arnaudcazale/XpertRide_Shield_PCB/3D/connecteur_male.pdf

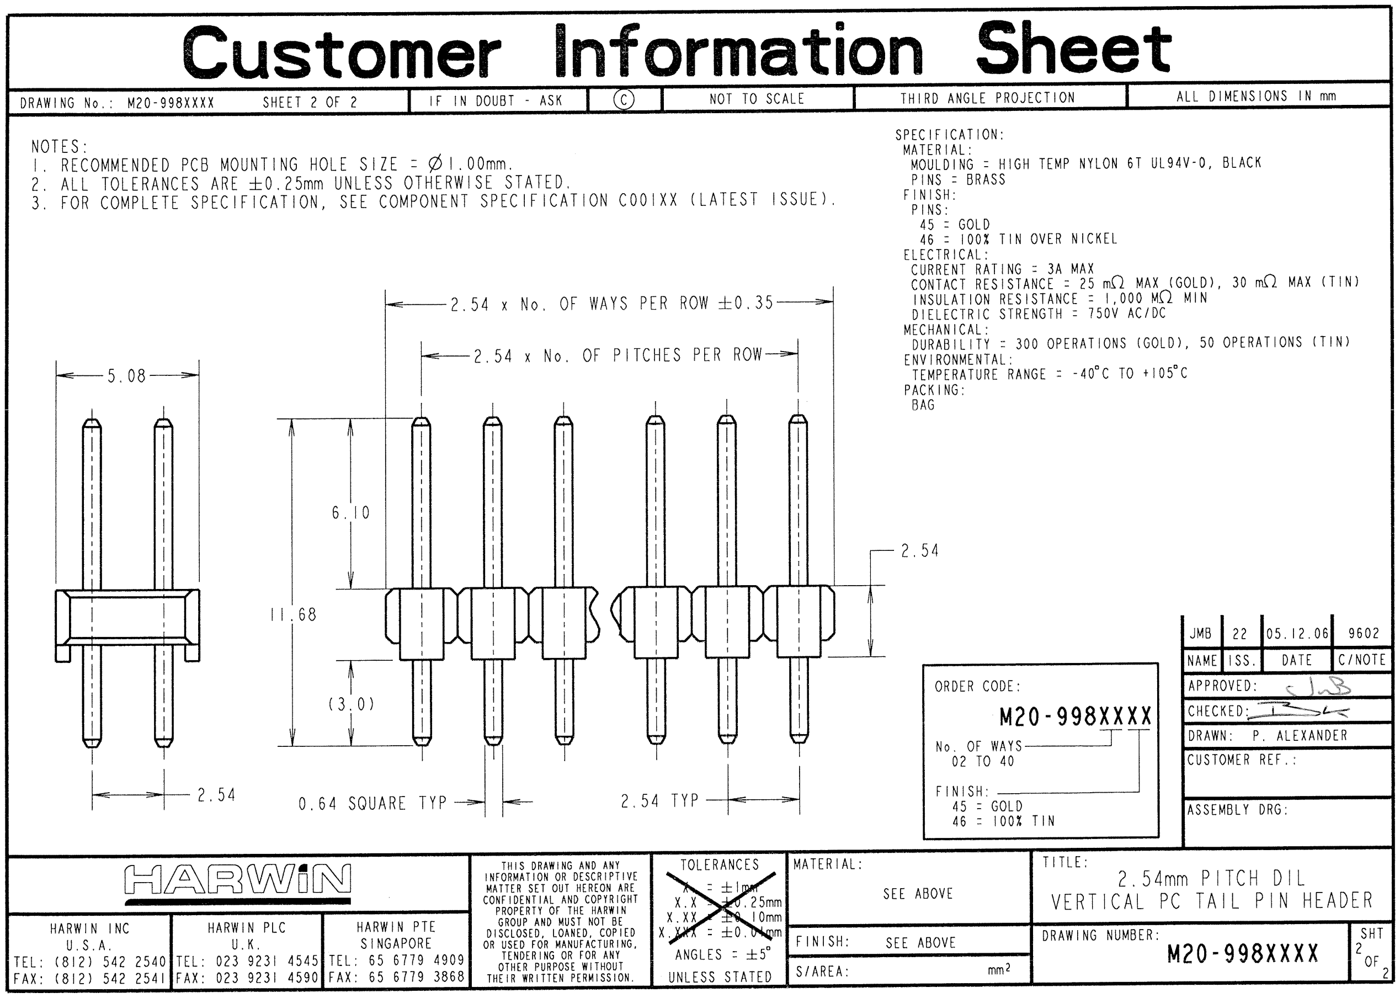
[picture p1: page 1]
