arnaudcazale/XpertRide_Shield_PCB/3D/connecteur_femelle.stp

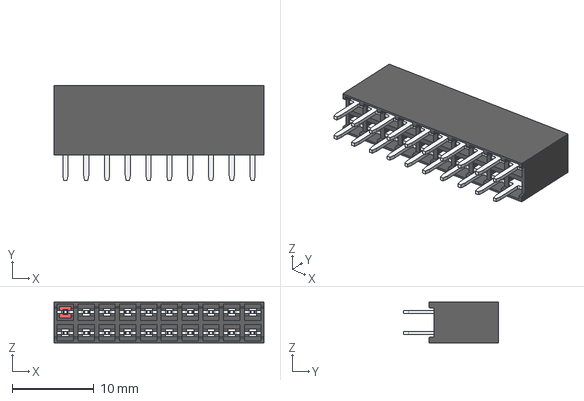
[picture p2: CAD file, 2020-06-02]
3D/connecteur_femelle.stp
25.6 x 11.6 x 5.00 mm
