arnaudcazale/XpertRide_Shield_PCB/3D/1593J.stp

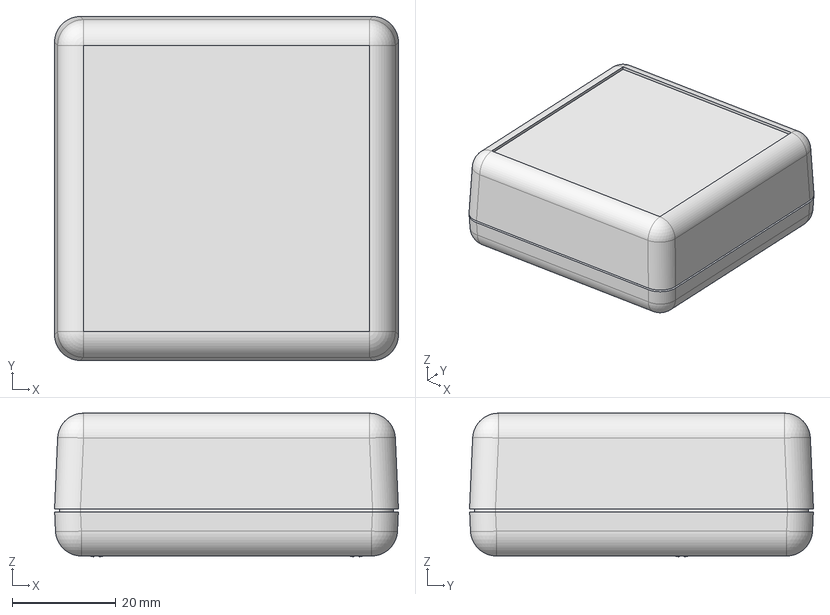
[picture p3: CAD file, 2020-04-24]
3D/1593J.stp
66.2 x 66.2 x 27.7 mm
1593J Base
1593J Cover
1593J PCB
