arnaudcazale/XpertRide_Shield_PCB/3D/assemblage Box-XpertRide.pdf

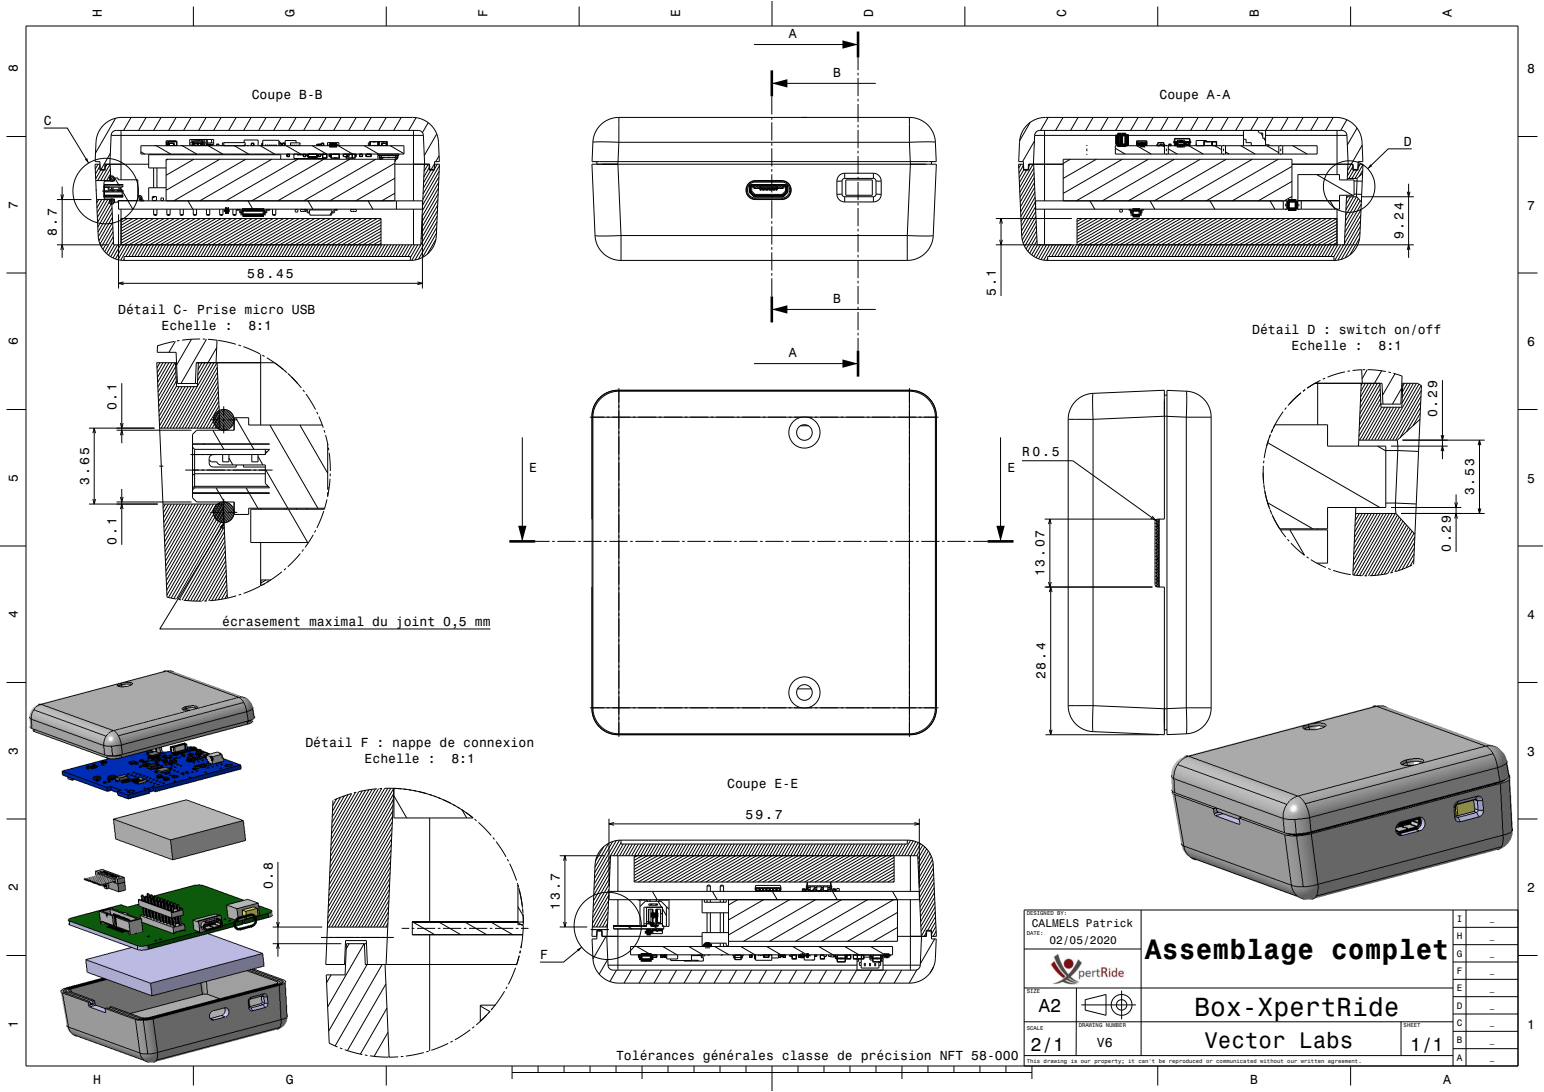
[picture p4: page 1]
DRAWING NUMBER; Vector Labs; DESIGNED BY: CALMELS Patrick; Assemblage complet; Coupe A-A; Coupe B-B; Coupe E-E; Echelle : 8:1

Détail C- Prise micro USB
Echelle : 8:1

Détail D : switch on/off

écrasement maximal du joint 0,5 mm

Détail F : nappe de connexion

Tolérances générales classe de précision NFT 58-000

This drawing is our property; it can't be reproduced or communicated without our written agreement.
