arnaudcazale/XpertRide_Shield_PCB/3D/mis en plan PCB Shield XpertRide V3.pdf

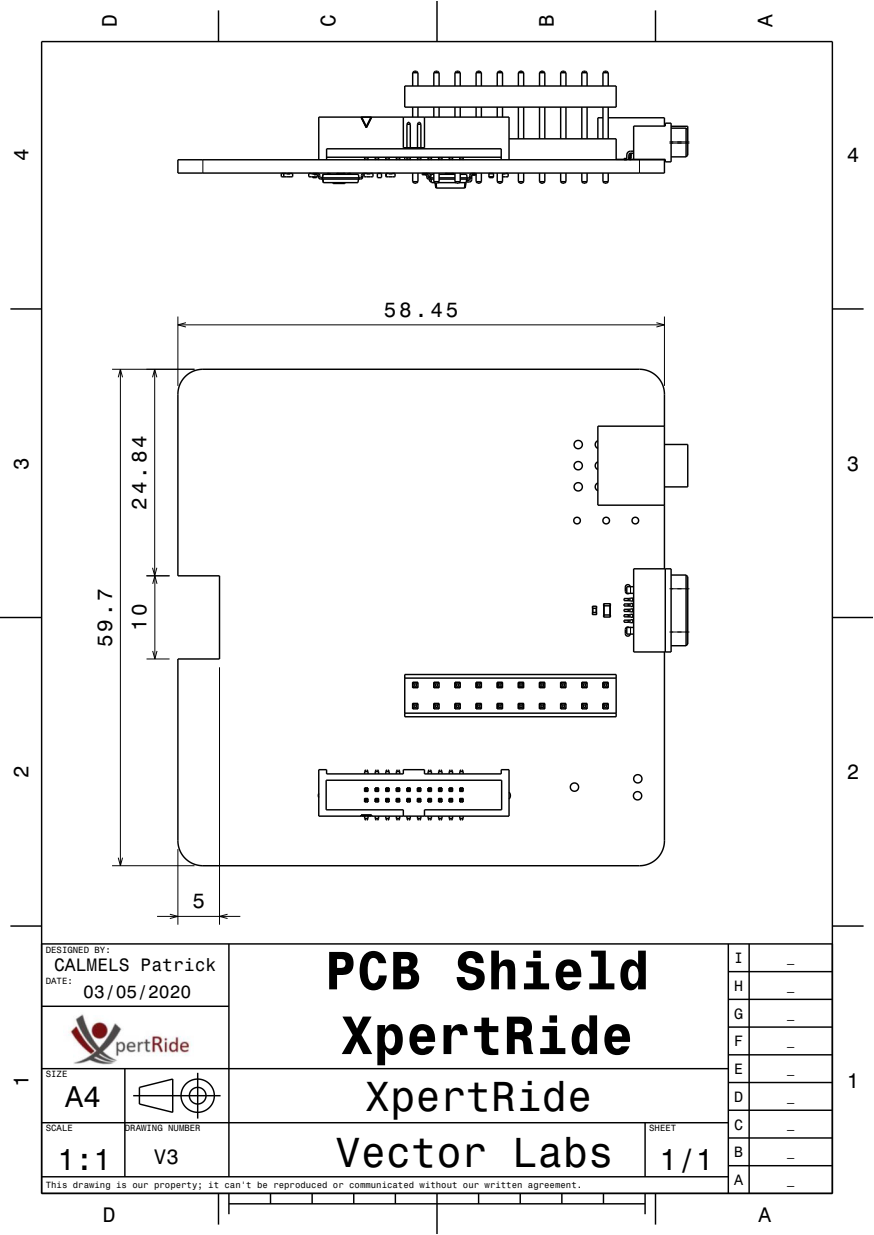
[picture p5: page 1]

03/05/2020 DESIGNED BY: CALMELS Patrick DATE: | PCB Shield XpertRide | I | _

SIZE A4 | | | | XpertRide

SCALE 1:1 | DRAWING NUMBER V3 | Vector Labs | SHEET 1/1

This drawing is our property; it can't be reproduced or communicated without our written agreement.
