arnaudcazale/XpertRide_Shield_PCB/3D/mise en plan box XpertRide.pdf

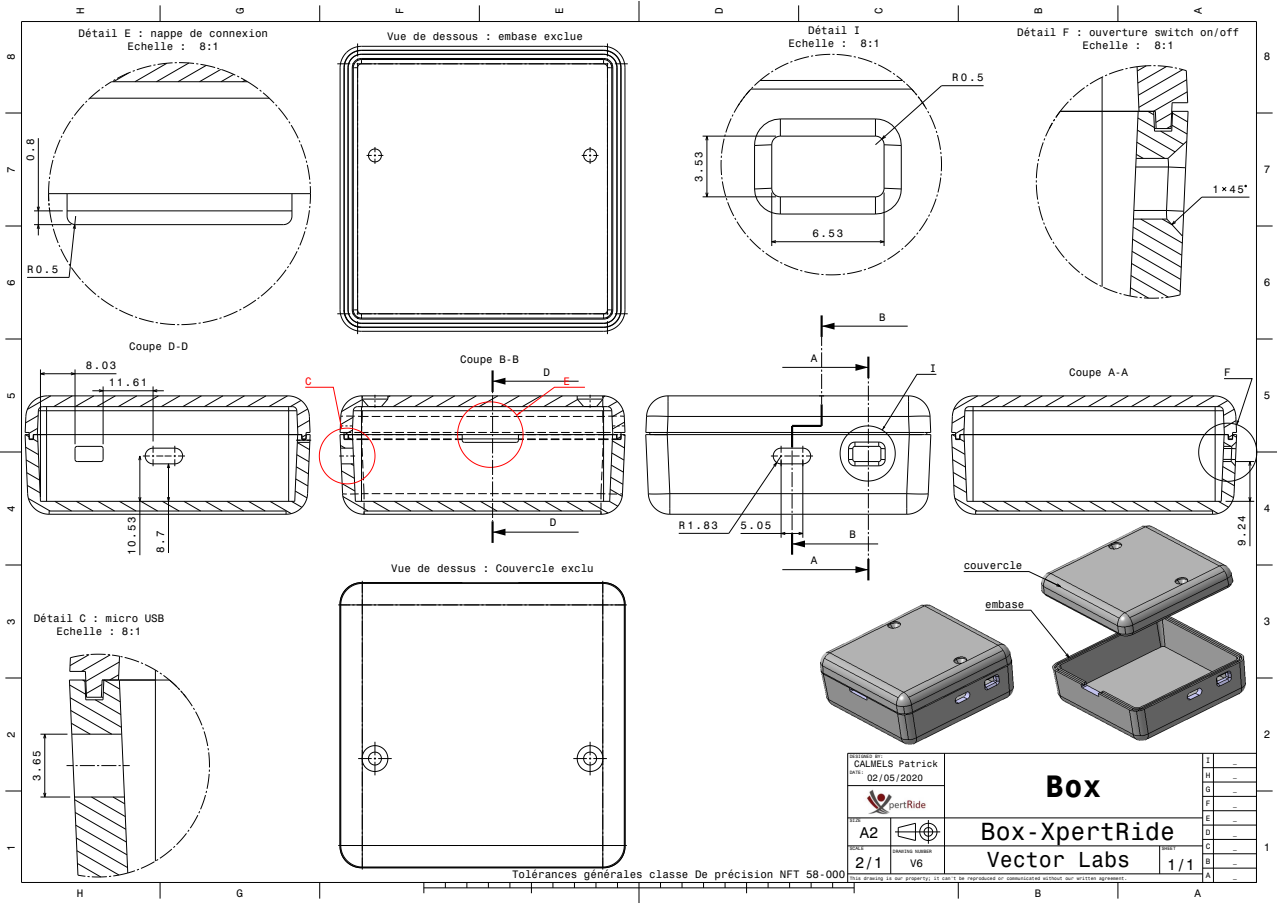
[picture p6: page 1]
Coupe A-A; Echelle : 8:1; Détail I Echelle : 8:1; Coupe B-B; Coupe D-D 10.53

Détail E : nappe de connexion

Vue de dessous : embase exclue

Détail F : ouverture switch on/off

Vue de dessus : Couvercle exclu

Détail C : micro USB
Echelle : 8:1

DESIGNED BY: CALMELS Patrick DATE: 02/05/2020 | Box | I | _

A2 SIZE | | | | Box-XpertRide

SCALE 2/1 | DRAWING NUMBER V6 | Vector Labs | SHEET 1/1

Tolérances générales classe De précision NFT 58-000

This drawing is our property; it can't be reproduced or communicated without our written agreement.
