arnaudcazale/XpertRide_Shield_PCB/shield/XpertRIde_v2.kicad_pcb

## KiCad design shield/XpertRIde_v2.kicad_pcb (2020-06-02)

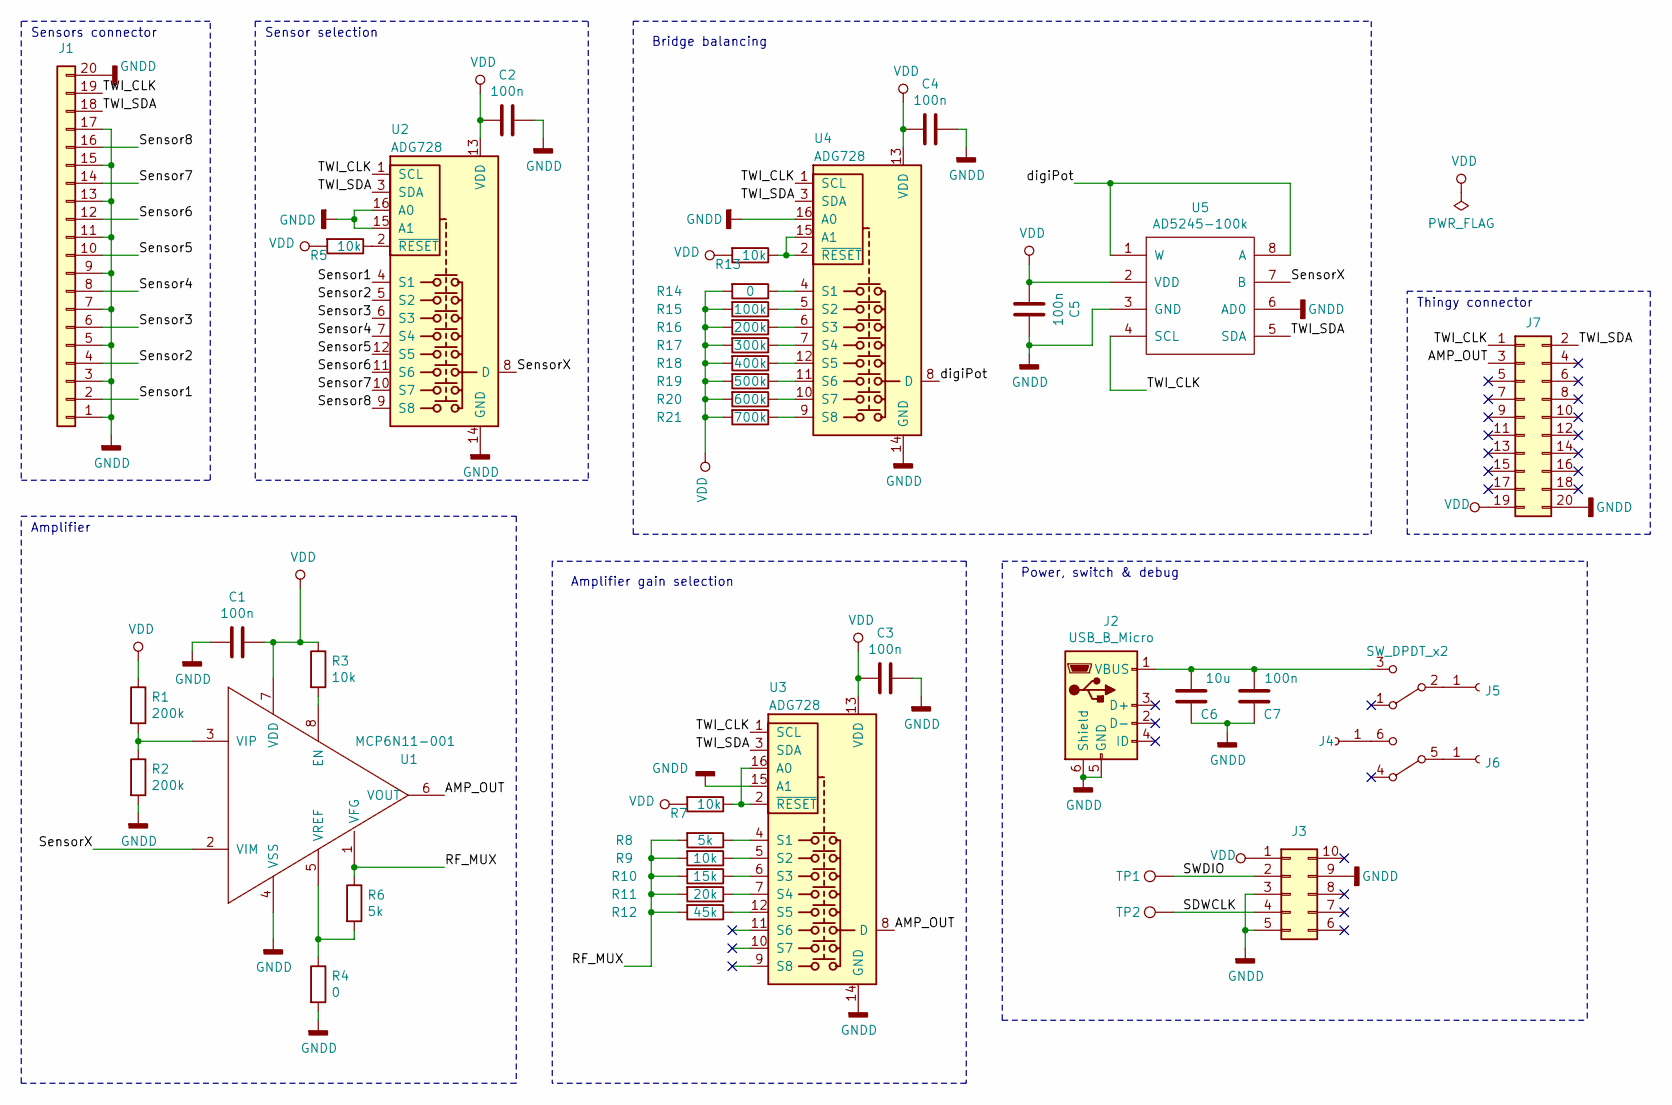
[picture p7: schematic XpertRIde_v2.sch]

Parts:
C1, C2, C3, C4, C5, C7: 100n; C_0402
C6: 10u; C_0603
J1: Conn_01x20; Samtec_ESHF_20
J2: USB_B_Micro; CUI_UJ2-MIBH-4-SMT-TR-67
J3: Conn_02x05_Counter_Clockwise; Tag_Connect_10
J4, J5, J6: Conn_01x01_Female; SolderWirePad_single_0-8mmDrill
J7: Conn_02x10_Odd_Even; Pin_Header_Straight_2x10_Pitch2.54mm
R1, R2, R16: 200k; R_0402
R3, R5, R7, R9, R13: 10k; R_0402
R4, R14: 0; R_0402
R6, R8: 5k; R_0402
R10: 15k; R_0402
R11: 20k; R_0402
R12: 45k; R_0402
R15: 100k; R_0402
R17: 300k; R_0402
R18: 400k; R_0402
R19: 500k; R_0402
R20: 600k; R_0402
R21: 700k; R_0402
SW1: SW_DPDT_x2; DPDT_IP67
TP1, TP2: TestPoint; Measurement_Point_Round-SMD-Pad_Small
U1: MCP6N11-001; SOIC-8_3.9x4.9mm_Pitch1.27mm
U2, U3, U4: ADG728; TSSOP-16_4.4x5mm_P0.65mm
U5: AD5245-100k; SOT-23-8

Connections:
/AMP_OUT: J7.3, U1.6 (VOUT), U3.8 (D)
/RF_MUX: R6.1, R8.2, R9.2, R10.2, R11.2, R12.2, U1.1 (VFG)
/SDWCLK: J3.4, TP2.1
/SWDIO: J3.2, TP1.1
/Sensor1: J1.2, U2.4 (S1)
/Sensor2: J1.4, U2.5 (S2)
/Sensor3: J1.6, U2.6 (S3)
/Sensor4: J1.8, U2.7 (S4)
/Sensor5: J1.10, U2.12 (S5)
/Sensor6: J1.12, U2.11 (S6)
/Sensor7: J1.14, U2.10 (S7)
/Sensor8: J1.16, U2.9 (S8)
/SensorX: U1.2 (VIM), U2.8 (D), U5.7 (B)
/TWI_CLK: J1.19, J7.1, U2.1 (SCL), U3.1 (SCL), U4.1 (SCL), U5.4 (SCL)
/TWI_SDA: J1.18, J7.2, U2.3 (SDA), U3.3 (SDA), U4.3 (SDA), U5.5 (SDA)
/digiPot: U4.8 (D), U5.1 (W), U5.8 (A)
GNDD: C1.2, C2.1, C3.1, C4.1, C5.1, C6.1, C7.1, J1.1, J1.3, J1.5, J1.7, J1.9, J1.11, J1.13, J1.15, J1.17, J1.20, J2.5 (GND), J2.6 (Shield), J3.3, J3.5, J3.9, J7.20, R2.2, R4.2, U1.4 (VSS), U2.14 (GND), U2.15 (A1), U2.16 (A0), U3.14 (GND), U3.15 (A1), U4.14 (GND), U4.16 (A0), U5.3 (GND), U5.6 (AD0)
unnamed: C6.2, C7.2, J2.1 (VBUS), SW1.3 (C)
unnamed: J4.1, SW1.6 (C)
unnamed: J5.1, SW1.2 (B)
unnamed: J6.1, SW1.5 (B)
unnamed: R1.2, R2.1, U1.3 (VIP)
unnamed: R3.2, U1.8 (EN)
unnamed: R4.1, R6.2, U1.5 (VREF)
unnamed: R5.1, U2.2 (~RESET)
unnamed: R7.1, U3.2 (~RESET), U3.16 (A0)
unnamed: R8.1, U3.4 (S1)
unnamed: R9.1, U3.5 (S2)
unnamed: R10.1, U3.6 (S3)
unnamed: R11.1, U3.7 (S4)
unnamed: R12.1, U3.12 (S5)
unnamed: R13.1, U4.2 (~RESET), U4.15 (A1)
unnamed: R14.1, U4.4 (S1)
unnamed: R15.1, U4.5 (S2)
unnamed: R16.1, U4.6 (S3)
unnamed: R17.1, U4.7 (S4)
unnamed: R18.1, U4.12 (S5)
unnamed: R19.1, U4.11 (S6)
unnamed: R20.1, U4.10 (S7)
unnamed: R21.1, U4.9 (S8)
VDD: C1.1, C2.2, C3.2, C4.2, C5.2, J3.1, J7.19, R1.1, R3.1, R5.2, R7.2, R13.2, R14.2, R15.2, R16.2, R17.2, R18.2, R19.2, R20.2, R21.2, U1.7 (VDD), U2.13 (VDD), U3.13 (VDD), U4.13 (VDD), U5.2 (VDD)

Notes on the sheet:
Bridge balancing
Amplifier
Amplifier gain selection
Sensors connector
Sensor selection
Power, switch & debug
Thingy connector

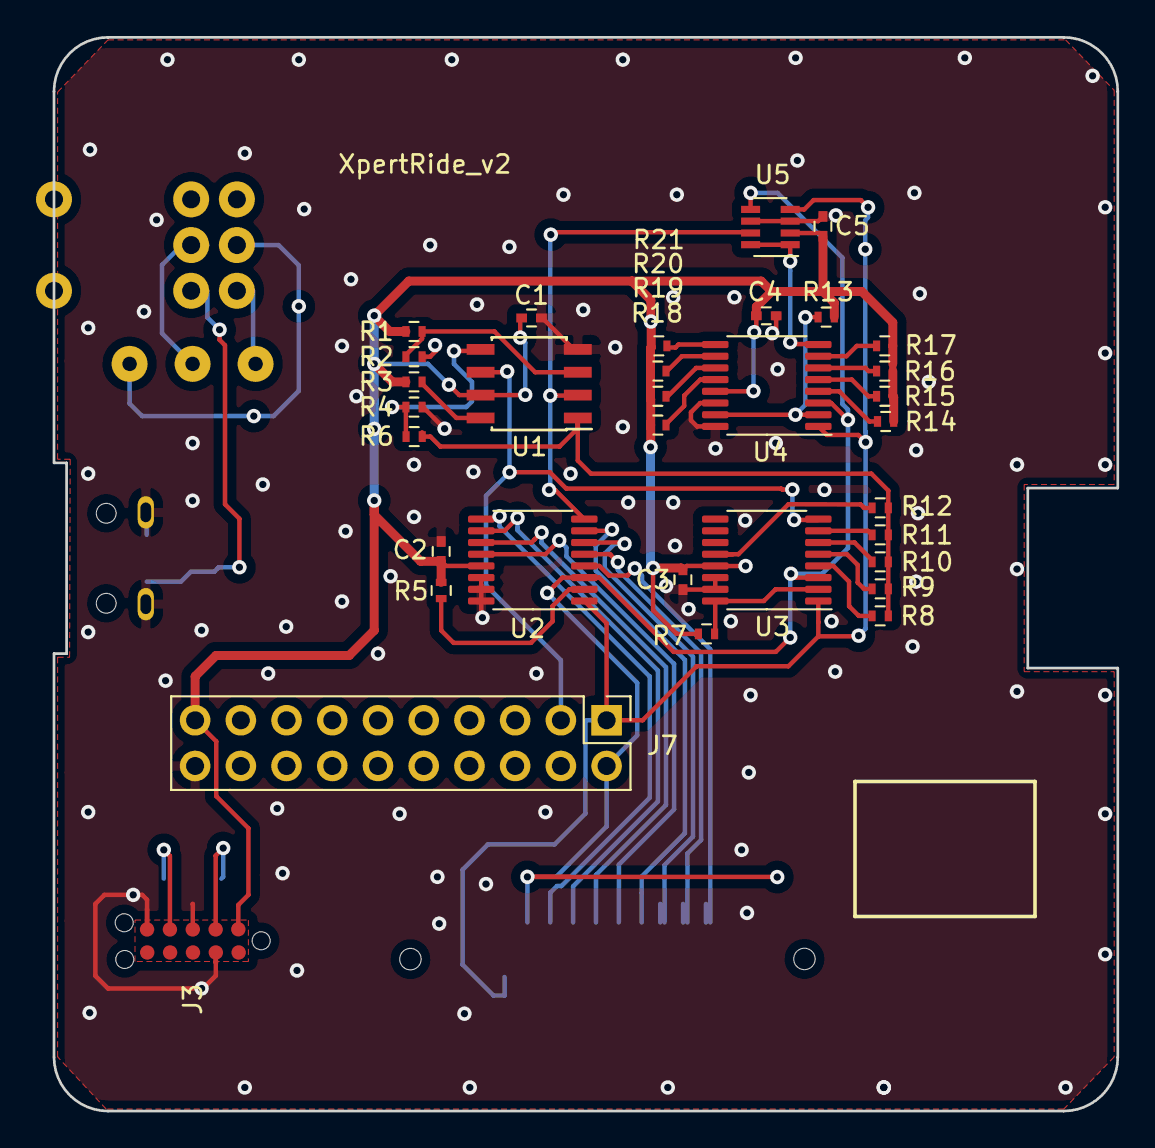
[picture p8: board XpertRIde_v2.kicad_pcb from above]

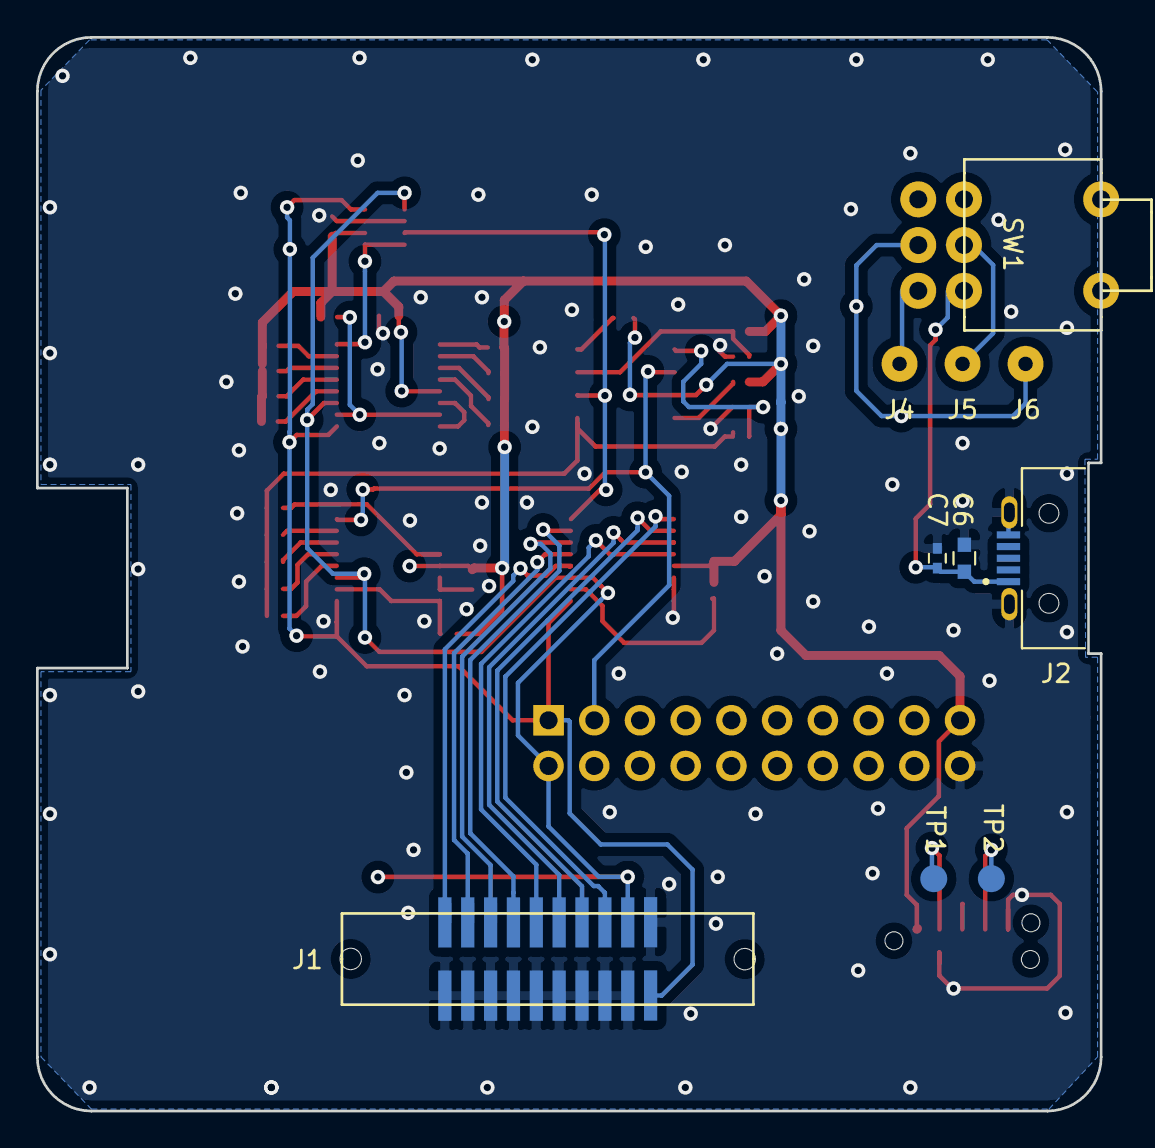
[picture p9: board XpertRIde_v2.kicad_pcb from below]

Board: 2 copper layers, 59.1 x 59.7 mm, 43 parts (10 on the bottom side), 41 nets.
