arnaudcazale/XpertRide_Shield_PCB/(commit log)

2020-04-22 main PCB OK
    [XpertRIde_v2.sch]
2020-04-22 support OK
    [XpertRIde_v2.kicad_pcb, support_ZIF.kicad_pcb, support_ZIF.sch, support_ZIF.step]
2020-04-24 3D sandwich
    [1593J.stp, XpertRIde_v2.kicad_pcb, XpertRIde_v2.sch, support_ZIF.kicad_pcb, support_ZIF.step]
2020-04-27 new design
    [XpertRIde_v2.kicad_pcb, XpertRIde_v2.sch, support_ZIF.kicad_pcb, support_ZIF.sch]
2020-05-04 new PCB dimensions
    [XpertRIde_v2.kicad_pcb]
2020-05-06 modif dimensions-joint
    [XpertRIde_v2.kicad_pcb]
2020-06-02 fixed switch position
    [XpertRIde_v2.kicad_pcb, XpertRIde_v2.sch, connecteur_femelle.stp]
